Chase-520/Westview-Capstone/images/milestone.gif

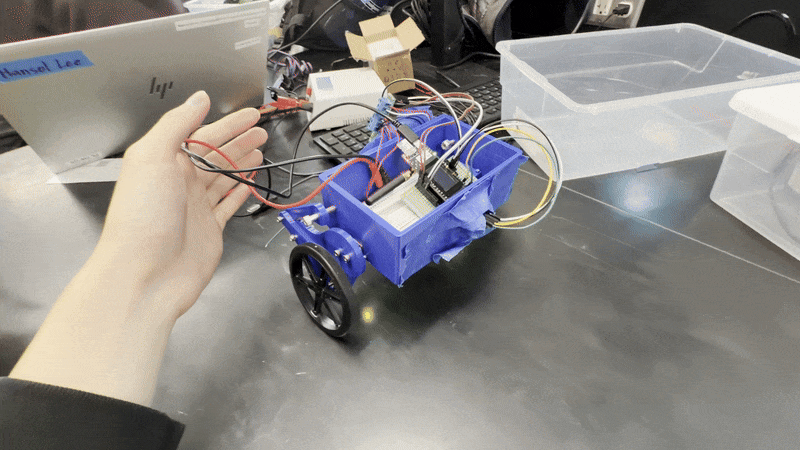
images/milestone.gif
