Chase-520/Westview-Capstone/BOM.xlsx

Name | Vendor | Description | Price | Quantity needed | Total | State | $178.03 | Notes
Encoder Motor 2PC (https://www.amazon.com/Encoder-7-5-3000RPM-Precision-Control-Arduino/dp/B0DB26TQVY?s=industrial) | Anreak | This will be the main motor for driving the robot, I'll purchase two with low rpm high torque for the joints and two medium rpm for the wheel. For torque calculation and power consumption, I'll use datasheet provided by polulu as a reference I tested this motor on 11/20 when Sanchay brough his motor to class (https://www.pololu.com/file/0J1487/pololu-micro-metal-gearmotors-rev-6-1.pdf) | $23.99 | 2 | $47.98 | Arrived |  | I might return the one I currently have and buy new ones with rpm around 600
H Bridge (https://www.pololu.com/product/2512) | Polulu | I'll need to use two of the dual motor H bridge to control the encoder motor | $17.95 | 2 | $35.90 | Arrived
9 axis imu (https://www.adafruit.com/product/4754) | Adafruit | I'll use this as my main sensor for orientation estimation. I've worked with this device before, I'll be using a I2C connection to contorl it | $24.95 | 1 | $24.95 | Arrived
GPIO Extension board (https://www.adafruit.com/product/5346) | Adafruit | This board will have all the encoder pins connected from the motors to the extension board for reading motor position | 5.95 | 1 | 5.95 | Arrived
Mounting Hub (https://www.pololu.com/product/1996) | Pololu | Buying combo with 5pc | 9.15 | 5 | 45.75 | Shipped
Wheel (https://www.pololu.com/product/1430) | Pololu | Just two wheels | 8.75 | 2 | 17.5 | Shipped
