Chase-520/Westview-Capstone/Arduino_code/MCP23017_blink.ino

// Blinks an LED attached to a MCP23XXX pin.

// ok to include only the one needed
// both included here to make things simple for example
#include <Adafruit_MCP23X17.h>

#define LED_PIN 0     // MCP23XXX pin LED is attached to

// only used for SPI
#define CS_PIN 6

// uncomment appropriate line
Adafruit_MCP23X17 mcp;
//Adafruit_MCP23X17 mcp;

void setup() {
  Serial.begin(9600);
  //while (!Serial);
  Serial.println("MCP23xxx Blink Test!");

  // uncomment appropriate mcp.begin
  if (!mcp.begin_I2C()) {
  //if (!mcp.begin_SPI(CS_PIN)) {
    Serial.println("Error.");
    while (1);
  }

  // configure pin for output
  mcp.pinMode(LED_PIN, OUTPUT);

  Serial.println("Looping...");

  mcp.pinMode(8, OUTPUT);
  mcp.digitalWrite(8, HIGH);  // Write to B pins
}

void loop() {
  mcp.digitalWrite(LED_PIN, HIGH);
  delay(500);
  mcp.digitalWrite(LED_PIN, LOW);
  delay(500);
}
