Chase-520/Westview-Capstone/(commit log)

2025-11-20 remove USCBiomechanic stsuff
    [data_output.csv, data_output_002.csv, data_output_003.csv]
2025-11-20 add N20 motoro with encoder arduino test code
2025-12-09 update code with polulu motor driver
2025-12-10 imu read & visualize
2025-12-10 Add Bluetooth MAC Address Scanner for ESP32
    This code scans for Bluetooth devices and displays their MAC addresses, including specific messages for gamepad controllers.
2025-12-15 Add MCP23017 LED blink example code
    This code blinks an LED connected to a MCP23XXX pin using the Adafruit MCP23X17 library.
2025-12-15 Add BLE device scanner for target MAC address
2025-12-18 Add joystick control for motor operation
2025-12-19 Add PID control for motor using BNO08x IMU
2026-01-05 Refactor motor control for dual motor setup
2026-01-12 Rename Electrical schematics-New.drawio (1).png to Electrical_schematics.png
2026-01-12 Rename Software Schematics.drawio.png to Software schematics.png
2026-01-12 Rename Software schematics.png to Software_schematics.png
2026-05-11 python simulation of dual arm scara and understanding the inverse kinematic
